pnyholm/resistors/README.md

resistors
=========

This repo contains the code used for the BYU ME 495R, Intro to Mechatronics, class robot competition. For a further description of the project, refer to theresistors.groups.et.byu.net
