pnyholm/resistors/(list of files, cad)

Other CAD files:
CAD_Files/RollerMounter.ipt
CAD_Files/base.ipt
CAD_Files/carousel-rev2.ipt
CAD_Files/carousel.ipt
CAD_Files/carousel_base.ipt
CAD_Files/carousel_hub.ipt
CAD_Files/chute_back.ipt
CAD_Files/chute_wall.ipt
CAD_Files/launcher_assembly.iam
CAD_Files/launcher_connector.ipt
CAD_Files/launcher_hinge.ipt
CAD_Files/launcher_motor.ipt
CAD_Files/launcher_wheel.ipt
CAD_Files/motor_mount.ipt
CAD_Files/ping_pong_ball.ipt
CAD_Files/robot.iam
CAD_Files/stepper_short.ipt
CAD_Files/tire.ipt
CAD_Files/wheel_assembly.iam
CAD_Files/wheel_hub.ipt
