pnyholm/resistors/EAGLE_Files/ShootingBoard.brd

## EAGLE design EAGLE_Files/ShootingBoard.brd (2013-08-14)

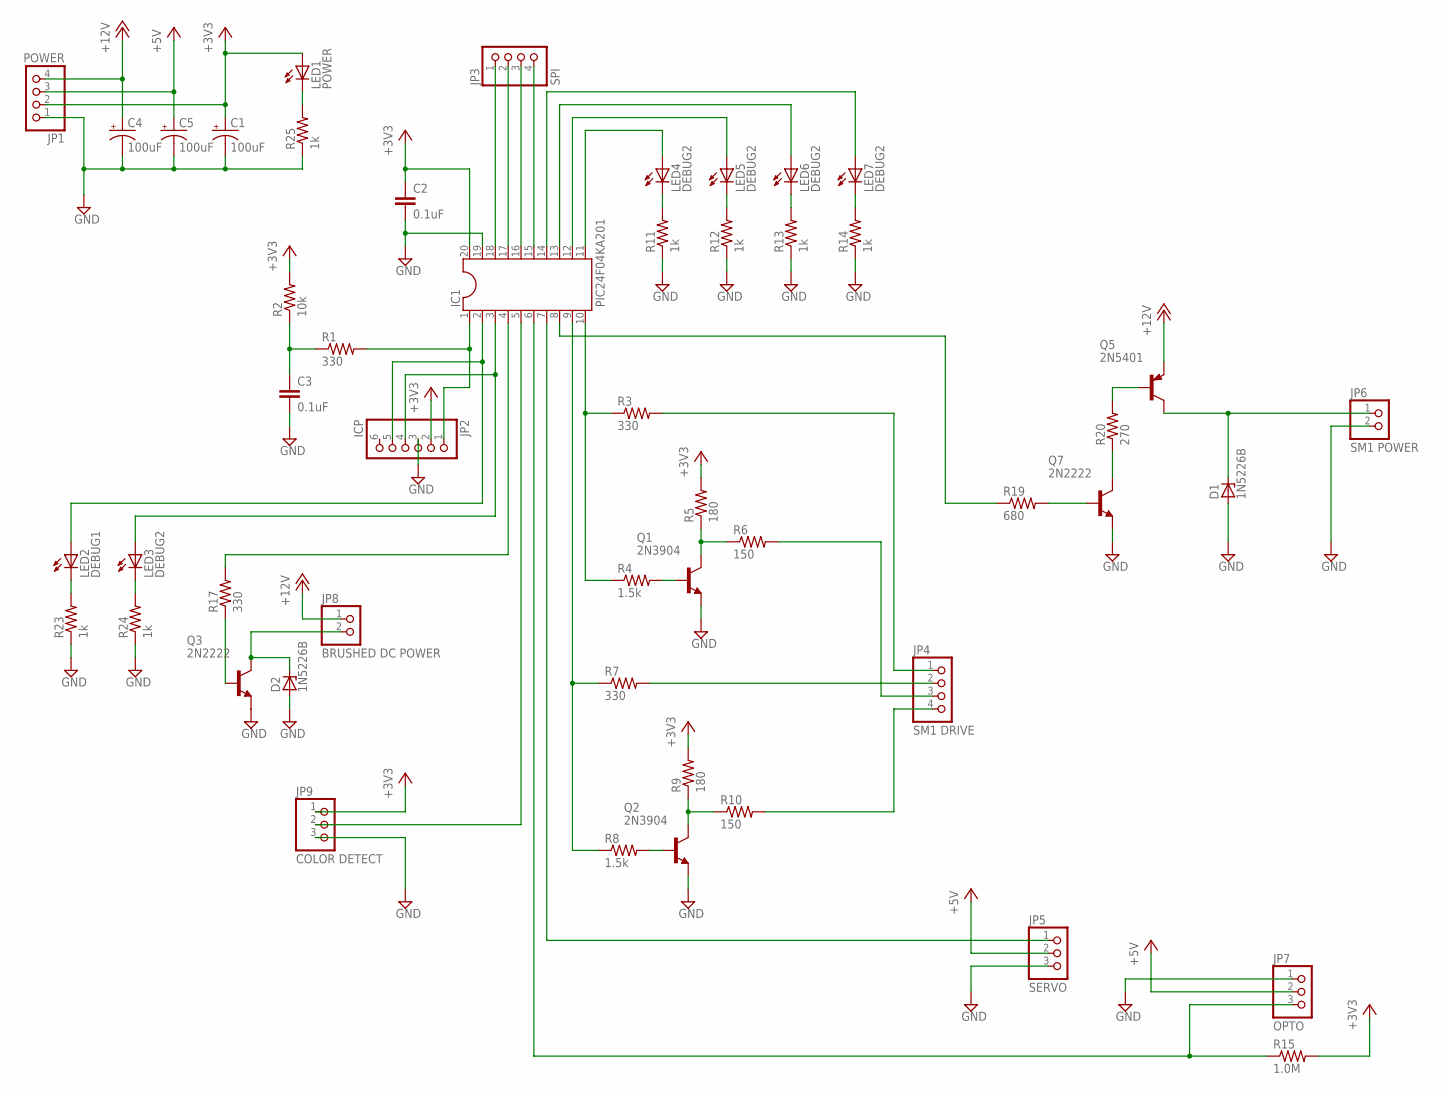
[picture p1: schematic ShootingBoard.sch]

Parts:
C1, C4, C5: 100uF; E2,5-7
C2, C3: 0.1uF; C0805
D1, D2: 1N5226B; DO35Z10
IC1: PIC24F04KA201; SOCKET-20
JP1: POWER; 1X04
JP2: ICP; 1X06
JP3: SPI; 1X04
JP4: SM1 DRIVE; 1X04
JP5: SERVO; 1X03
JP6: SM1 POWER; 1X02
JP7: OPTO; 1X03
JP8: BRUSHED DC POWER; 1X02
JP9: COLOR DETECT; 1X03
LED1: POWER; LED3MM
LED2: DEBUG1; LED3MM
LED3, LED4, LED5, LED6, LED7: DEBUG2; LED3MM
Q1, Q2: 2N3904; TO92
Q3, Q7: 2N2222; TO92
Q5: 2N5401; TO92
R1, R3, R7, R17: 330; R0805
R2: 10k; R0805
R4, R8: 1.5k; R0805
R5, R9: 180; R0805
R6, R10: 150; R0805
R11, R12, R13, R14, R23, R24, R25: 1k; R0805
R15: 1.0M; R0805
R19: 680; R0805
R20: 270; R0805

Connections:
+3V3: C1.+, C2.1, IC1.20, JP1.2, JP2.2, JP9.1, LED1.A, R2.2, R5.2, R9.2, R15.2
+5V: C5.+, JP1.3, JP5.2, JP7.2
+12V: C4.+, JP1.4, JP8.1, Q5.3 (E)
GND: C1.-, C2.2, C3.2, C4.-, C5.-, D1.A, D2.A, IC1.19, JP1.1, JP2.3, JP5.3, JP6.2, JP7.1, JP9.3, Q1.3 (E), Q2.3 (E), Q3.3 (E), Q7.3 (E), R11.1, R12.1, R13.1, R14.1, R23.1, R24.1, R25.1
unnamed: IC1.1, JP2.1, R1.2
unnamed: C3.1, R1.1, R2.1
unnamed: IC1.2, JP2.5, LED2.A
unnamed: IC1.3, JP2.4, LED3.A
unnamed: IC1.10, R3.1, R4.1
unnamed: Q1.1 (C), R5.1, R6.1
unnamed: Q1.2 (B), R4.2
unnamed: IC1.9, R7.1, R8.1
unnamed: Q2.1 (C), R9.1, R10.1
unnamed: Q2.2 (B), R8.2
unnamed: IC1.11, LED4.A
unnamed: LED4.K (C), R11.2
unnamed: IC1.12, LED5.A
unnamed: LED5.K (C), R12.2
unnamed: IC1.13, LED6.A
unnamed: LED6.K (C), R13.2
unnamed: JP4.1, R3.2
unnamed: JP4.2, R7.2
unnamed: JP4.3, R6.2
unnamed: JP4.4, R10.2
unnamed: IC1.14, LED7.A
unnamed: LED7.K (C), R14.2
unnamed: IC1.6, JP7.3, R15.1
unnamed: IC1.5, JP9.2
unnamed: IC1.4, R17.2
unnamed: Q7.1 (C), R20.1
unnamed: Q5.2 (B), R20.2
unnamed: D1.C, JP6.1, Q5.1 (C)
unnamed: D2.C, JP8.2, Q3.1 (C)
unnamed: IC1.7, JP5.1
unnamed: Q7.2 (B), R19.2
unnamed: Q3.2 (B), R17.1
unnamed: IC1.8, R19.1
unnamed: IC1.18, JP3.1
unnamed: IC1.17, JP3.2
unnamed: IC1.16, JP3.3
unnamed: IC1.15, JP3.4
unnamed: LED2.K (C), R23.2
unnamed: LED3.K (C), R24.2
unnamed: LED1.K (C), R25.2

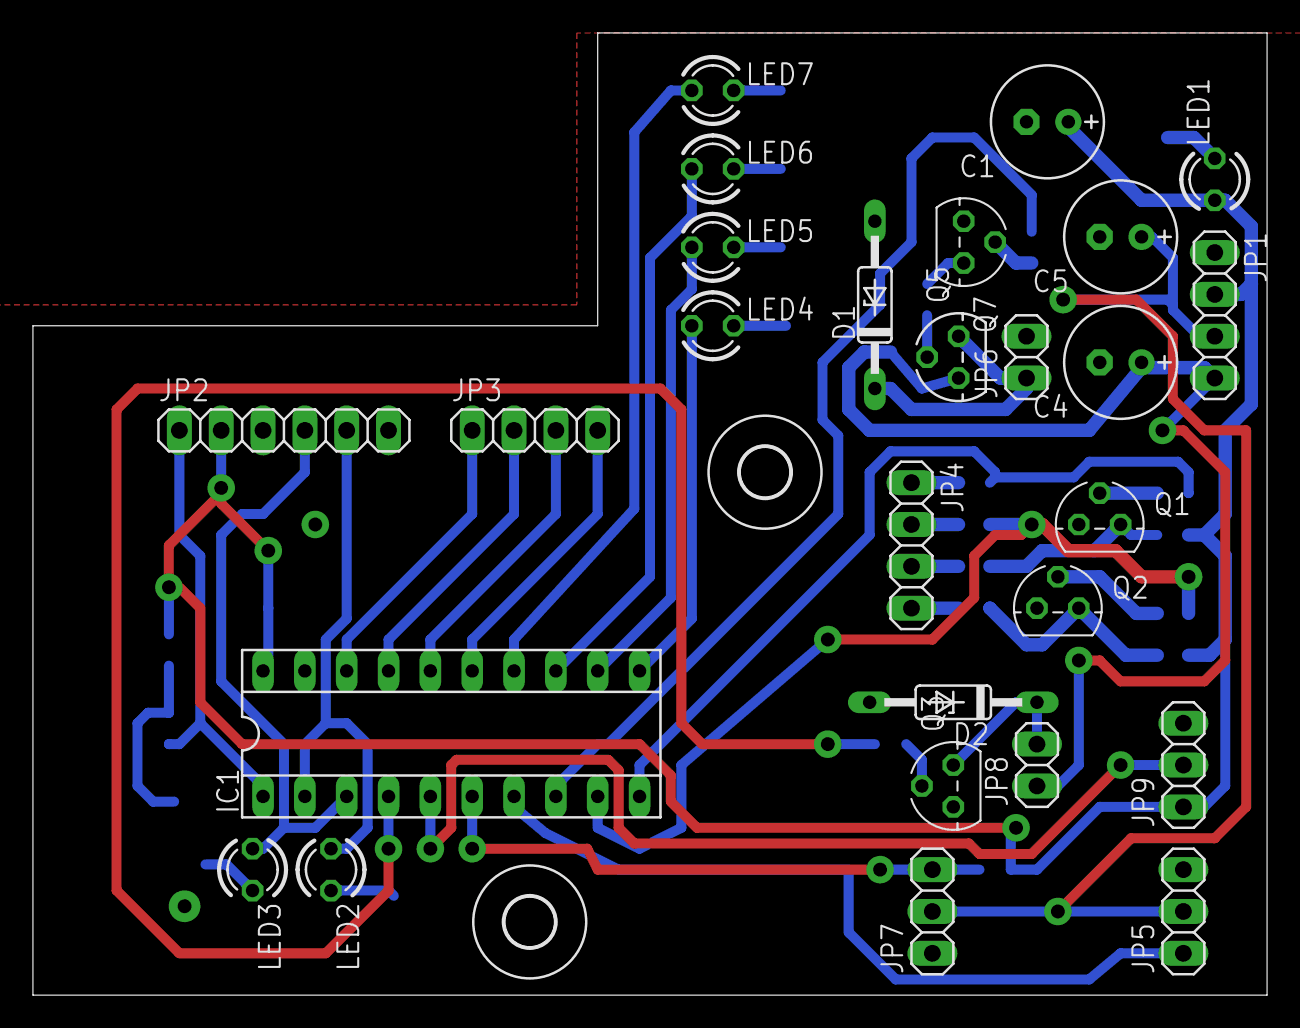
[picture p2: board ShootingBoard.brd from above]

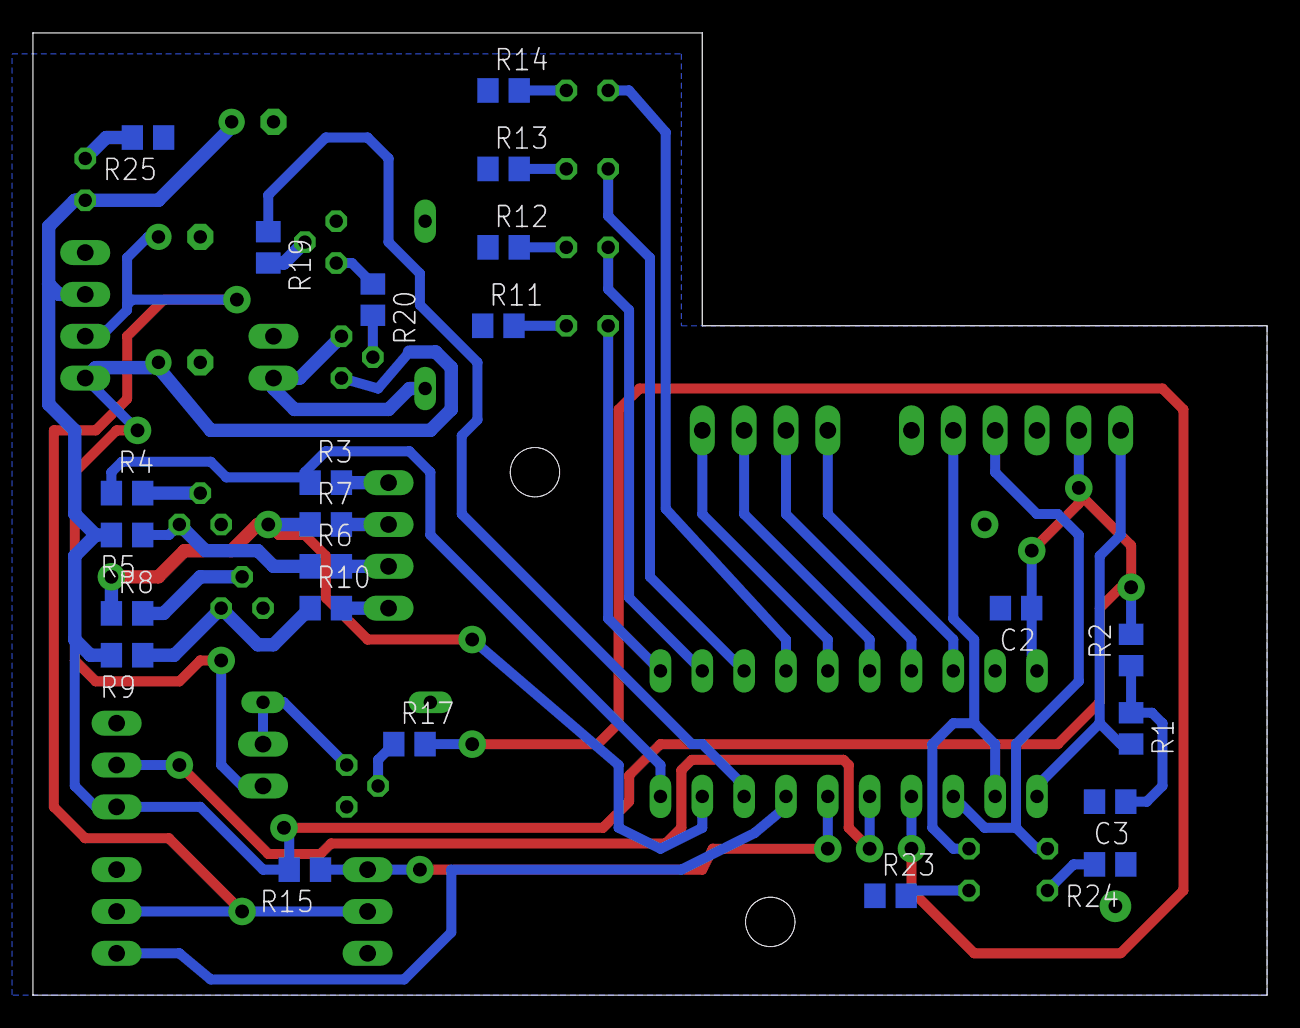
[picture p3: board ShootingBoard.brd from below]

Board: 2 copper layers, 74.9 x 58.4 mm, 52 parts (23 on the bottom side), 44 nets.

Other parts of the board:
U$1, U$2: 3,0
