pnyholm/resistors/EAGLE_Files/IR_Signal_Conditioning-v1.0.brd

## EAGLE design EAGLE_Files/IR_Signal_Conditioning-v1.0.brd (2013-08-14)

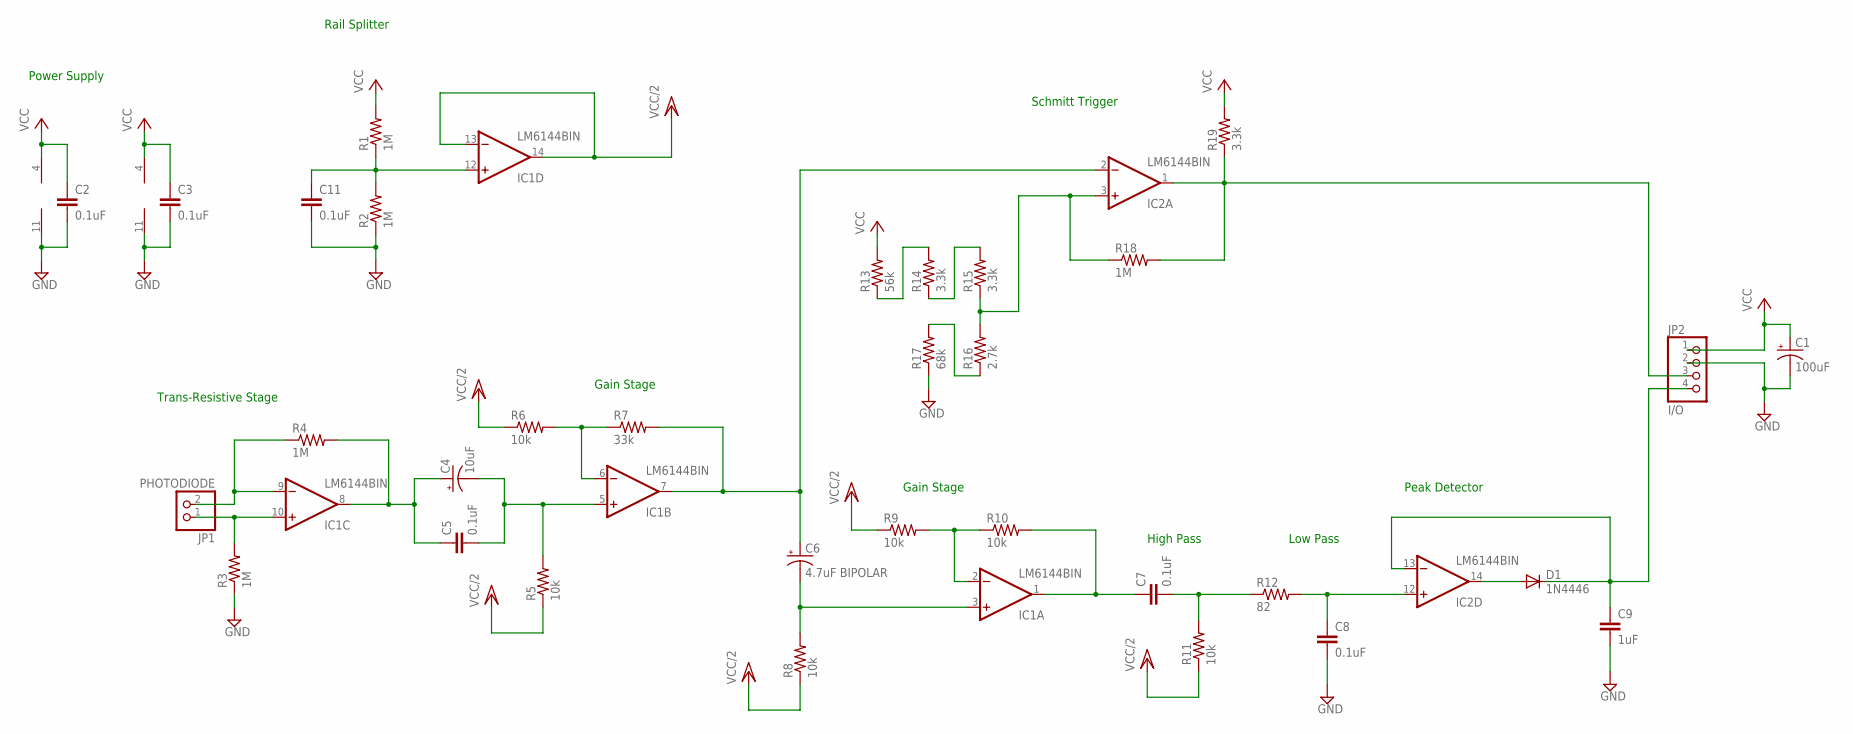
[picture p4: schematic IR_Signal_Conditioning-v1.0.sch]

Parts:
C1: 100uF; E2-5
C2, C3, C5, C7, C8, C11: 0.1uF; C0805
C4: 10uF; E2-5
C6: 4.7uF BIPOLAR; E2-5
C9: 1uF; C0805
D1: 1N4446; DO35-10
IC1, IC2: LM6144BIN; DIL14
JP1: PHOTODIODE; 1X02
JP2: I/O; 1X04
R1, R2, R3, R4, R18: 1M; R0805
R5, R6, R8, R9, R10, R11: 10k; R0805
R7: 33k; R0805
R12: 82; R0805
R13: 56k; R0805
R14, R15, R19: 3.3k; R0805
R16: 2.7k; R0805
R17: 68k; R0805

Connections:
GND: C1.-, C2.2, C3.2, C8.2, C9.2, C11.2, IC1.11 (V-), IC2.11 (V-), JP2.2, R2.1, R3.1, R17.1
unnamed: IC1.10 (+IN), JP1.1, R3.2
unnamed: IC1.9 (-IN), JP1.2, R4.1
unnamed: C4.+, C5.1, IC1.8 (OUT), R4.2
unnamed: C4.-, C5.2, IC1.5 (+IN), R5.2
unnamed: IC1.6 (-IN), R6.2, R7.1
unnamed: C6.+, IC1.7 (OUT), IC2.2 (-IN), R7.2
unnamed: C6.-, IC1.3 (+IN), R8.2
unnamed: IC1.2 (-IN), R9.2, R10.1
unnamed: C7.1, IC1.1 (OUT), R10.2
unnamed: C7.2, R11.2, R12.1
unnamed: D1.A, IC2.14 (OUT)
unnamed: C8.1, IC2.12 (+IN), R12.2
unnamed: C9.1, D1.C, IC2.13 (-IN), JP2.4
unnamed: R13.1, R14.2
unnamed: R14.1, R15.2
unnamed: IC2.3 (+IN), R15.1, R16.2, R18.1
unnamed: R16.1, R17.2
unnamed: IC2.1 (OUT), JP2.3, R18.2, R19.1
unnamed: C11.1, IC1.12 (+IN), R1.1, R2.2
VCC: C1.+, C2.1, C3.1, IC1.4 (V+), IC2.4 (V+), JP2.1, R1.2, R13.2, R19.2
VCC/2: IC1.13 (-IN), IC1.14 (OUT), R5.1, R6.1, R8.1, R9.1, R11.1

Notes on the sheet:
Schmitt Trigger
Trans-Resistive Stage
Gain Stage
Peak Detector
Rail Splitter
High Pass
Low Pass
Power Supply

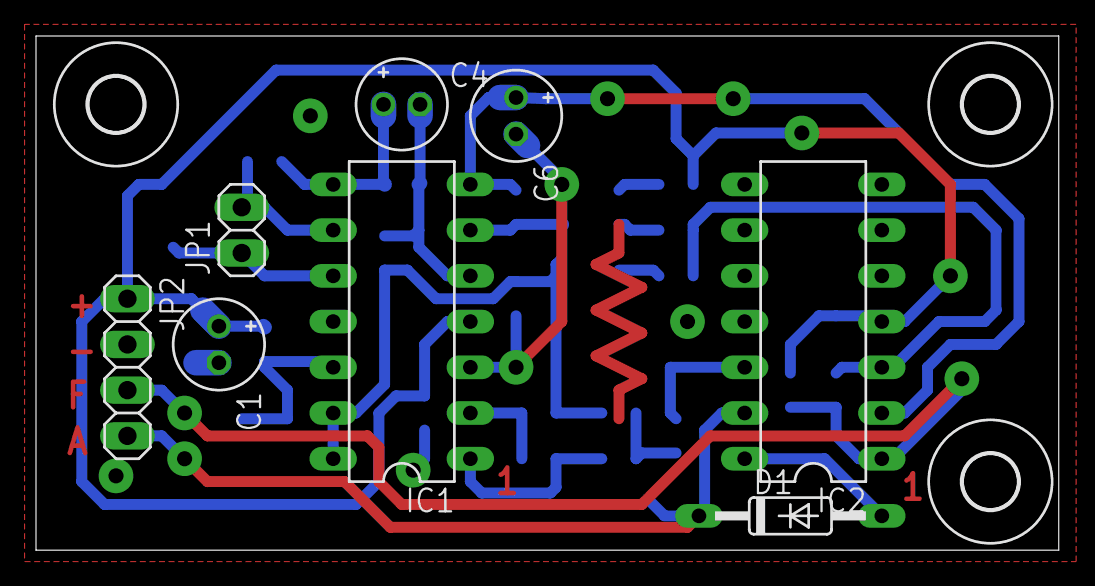
[picture p5: board IR_Signal_Conditioning-v1.0.brd from above]

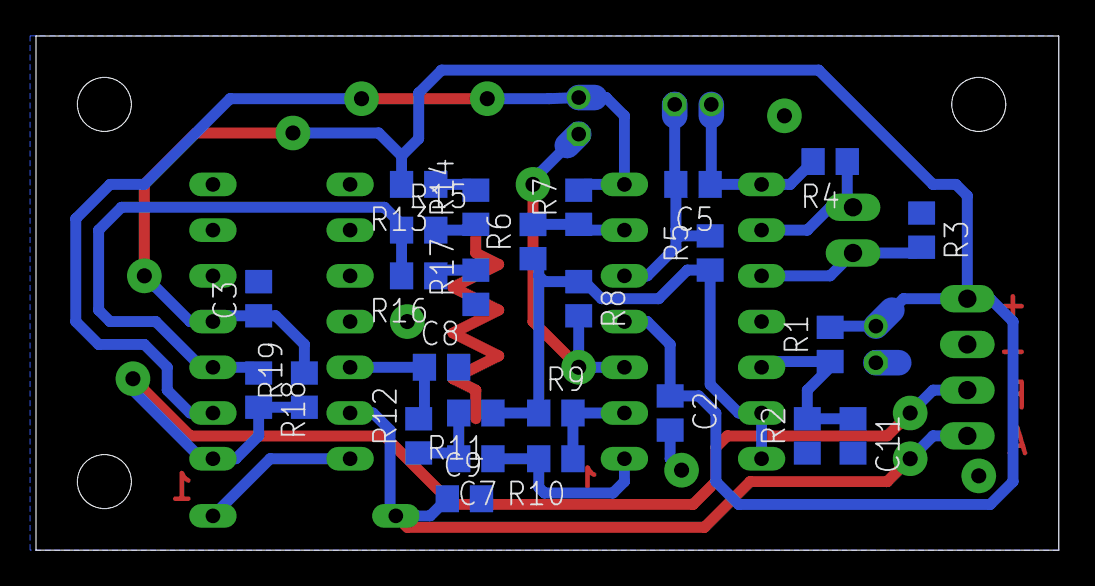
[picture p6: board IR_Signal_Conditioning-v1.0.brd from below]

Board: 2 copper layers, 56.8 x 28.6 mm, 37 parts (26 on the bottom side), 22 nets.

Other parts of the board:
U$1, U$2, U$3: 3,0
