pnyholm/resistors/EAGLE_Files/JonesHBridge.brd

## EAGLE design EAGLE_Files/JonesHBridge.brd (2013-08-14)

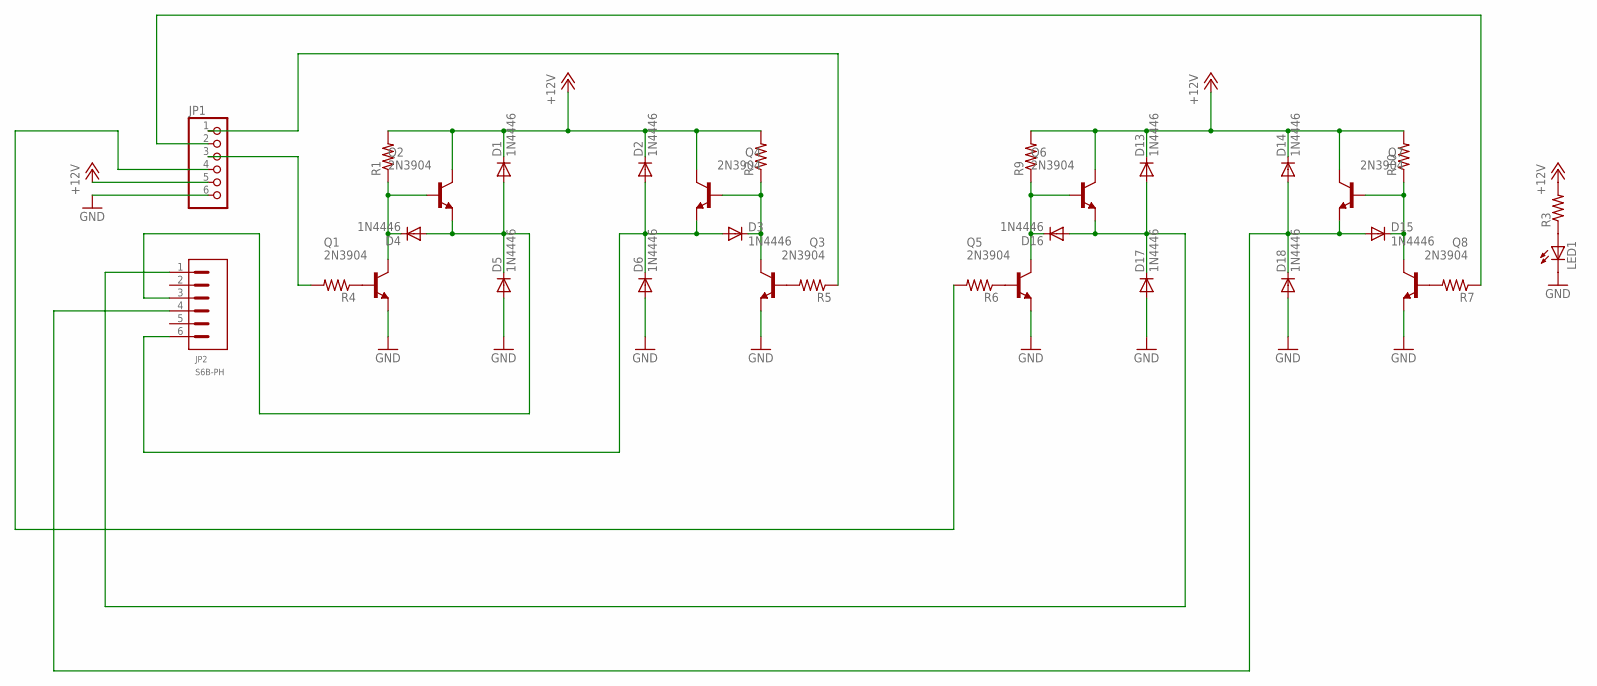
[picture p7: schematic JonesHBridge.sch]

Parts:
D1, D2, D3, D4, D5, D6, D13, D14, D15, D16, D17, D18: 1N4446; DO35-10
JP1: PINHD-1X6; 1X06
JP2: S6B-PH; S6B
LED1: LED3MM
Q1, Q2, Q3, Q4, Q5, Q6, Q7, Q8: 2N3904; TO92
R1, R2, R3, R4, R5, R6, R7, R9, R10: R-US_R0805; R0805

Connections:
+12V: D1.C, D2.C, D13.C, D14.C, JP1.5, Q2.1 (C), Q4.1 (C), Q6.1 (C), Q7.1 (C), R1.2, R2.2, R3.2, R9.2, R10.2
GND: D5.A, D6.A, D17.A, D18.A, JP1.6, LED1.K (C), Q1.3 (E), Q3.3 (E), Q5.3 (E), Q8.3 (E)
unnamed: D4.C, Q1.1 (C), Q2.2 (B), R1.1
unnamed: D1.A, D4.A, D5.C, JP2.3, Q2.3 (E)
unnamed: Q1.2 (B), R4.1
unnamed: LED1.A, R3.1
unnamed: Q5.2 (B), R6.1
unnamed: Q3.2 (B), R5.2
unnamed: D2.A, D3.A, D6.C, JP2.6, Q4.3 (E)
unnamed: D3.C, Q3.1 (C), Q4.2 (B), R2.1
unnamed: Q8.2 (B), R7.2
unnamed: D16.C, Q5.1 (C), Q6.2 (B), R9.1
unnamed: D15.C, Q7.2 (B), Q8.1 (C), R10.1
unnamed: D14.A, D15.A, D18.C, JP2.4, Q7.3 (E)
unnamed: D13.A, D16.A, D17.C, JP2.1, Q6.3 (E)
unnamed: JP1.3, R4.2
unnamed: JP1.1, R5.1
unnamed: JP1.2, R7.1
unnamed: JP1.4, R6.2

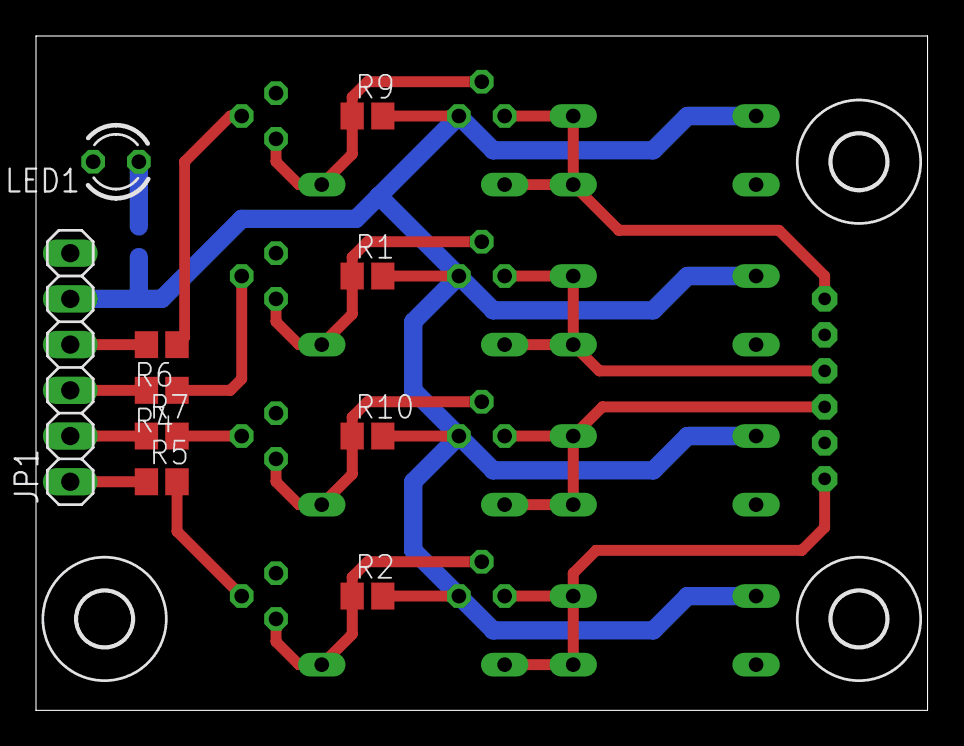
[picture p8: board JonesHBridge.brd from above]

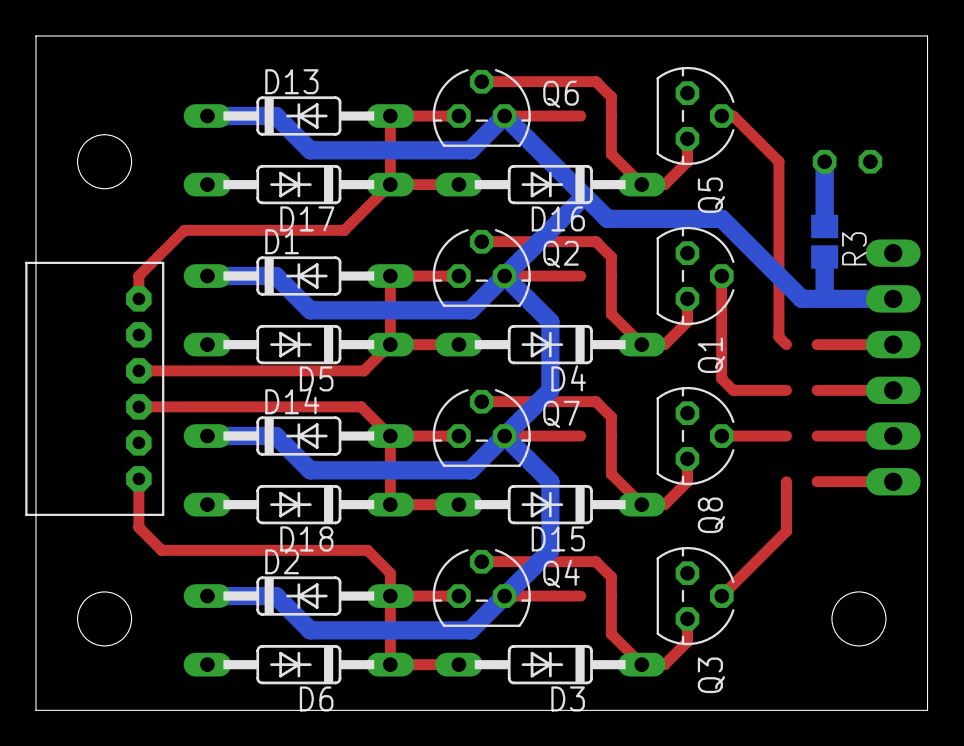
[picture p9: board JonesHBridge.brd from below]

Board: 2 copper layers, 49.5 x 37.5 mm, 35 parts (22 on the bottom side), 19 nets.

Other parts of the board:
U$1, U$2, U$3: 3,0
