pnyholm/resistors/EAGLE_Files/ColorDetection.brd

## EAGLE design EAGLE_Files/ColorDetection.brd (2013-08-14)

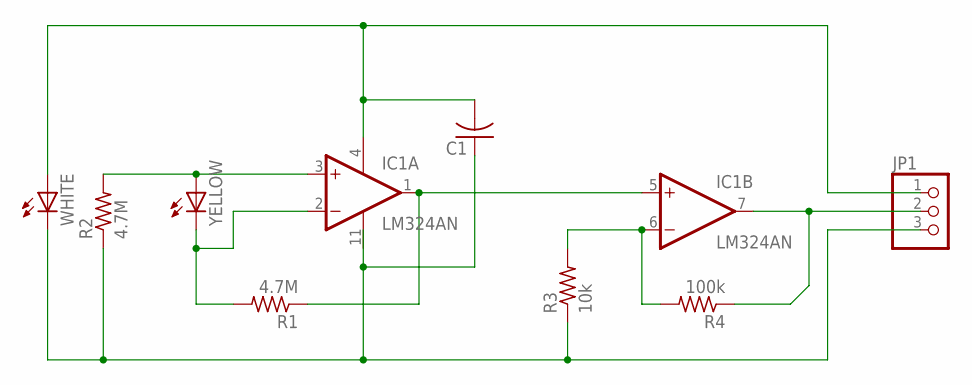
[picture p10: schematic ColorDetection.sch]

Parts:
C1: C-USC0805; C0805
IC1: LM324AN; DIL14
JP1: PINHD-1X3; 1X03
R1, R2: 4.7M; M0805
R3: 10k; M0805
R4: 100k; M0805
WHITE: LED10MM
YELLOW: LED5MM

Connections:
3V3: C1.2, IC1.4 (V+), JP1.1, WHITE.A
GND: C1.1, JP1.3, R2.1, R3.1, WHITE.K (C)
unnamed: IC1.3 (+IN), R2.2, YELLOW.A
unnamed: IC1.2 (-IN), R1.2, YELLOW.K (C)
unnamed: IC1.1 (OUT), IC1.5 (+IN), R1.1
unnamed: IC1.6 (-IN), R3.2, R4.2
unnamed: IC1.7 (OUT), JP1.2, R4.1
V-: IC1.11 (V-)

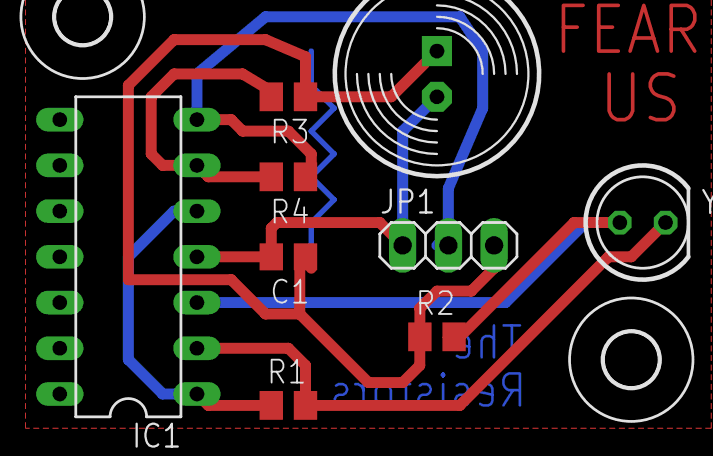
[picture p11: board ColorDetection.brd from above]

Board: 2 copper layers, 11 parts (0 on the bottom side), 7 nets.

Other parts of the board:
U$1, U$2: 3,0
