pnyholm/resistors/MPLABX_Files/Shooting.X/Servo.h

/* 
 * File:   Servo.h
 * Author: dkboone
 *
 * Created on August 9, 2013, 10:01 PM
 */

#ifndef SERVO_H
#define	SERVO_H

#include <p24F04KA201.h>
#include "GlobalConfig.h"

int moveOut(void);
int moveIn(void);

#endif	/* SERVO_H */
