pnyholm/resistors/MPLABX_Files/Shooting.X/OptoInterrupt.h

/* 
 * File:   OptoInterrupt.h
 * Author: pnyholm
 *
 * Created on August 9, 2013, 7:29 AM
 */

#ifndef OPTOINTERRUPT_H
#define	OPTOINTERRUPT_H

#include <p24F04KA201.h>
#include "GlobalConfig.h"

void initOptoInterrupt(void);

#endif	/* OPTOINTERRUPT_H */
