pnyholm/resistors/(commit log)

2013-07-19 Source to configure SPI
2013-07-19 Header for SPI configuration
2013-07-27 updated SerialCom files to their latest state (slave still does not recieve the message correctly_), also added the RangeFinder code for the test board
    [ConfigureSPI.c, ConfigureSPI.h]
2013-07-29 Send one byte of data, slave recieves correctly. Needs refining, but it works
    [ConfigureSPI.c]
2013-08-06 Create SERVO
2013-08-09 It works now, needs to be tuned once it is mounted on the bot
2013-08-14 new file structure for repo and website
    [ColorDetection.brd, ColorDetection.sch, IR_Signal_Conditioning-v1.0.brd, IR_Signal_Conditioning-v1.0.sch, JonesHBridge.brd, JonesHBridge.sch, NavigationBoard.brd, NavigationBoard.sch]
